UBC-Rocket/Thrust-Vectoring-II/README.md

# Thrust-Vectoring-II

Trying our best to make our rockets go up straight and not turn into a missile...
