UBC-Rocket/Thrust-Vectoring-II/Mechanical/Gimbal v29.step

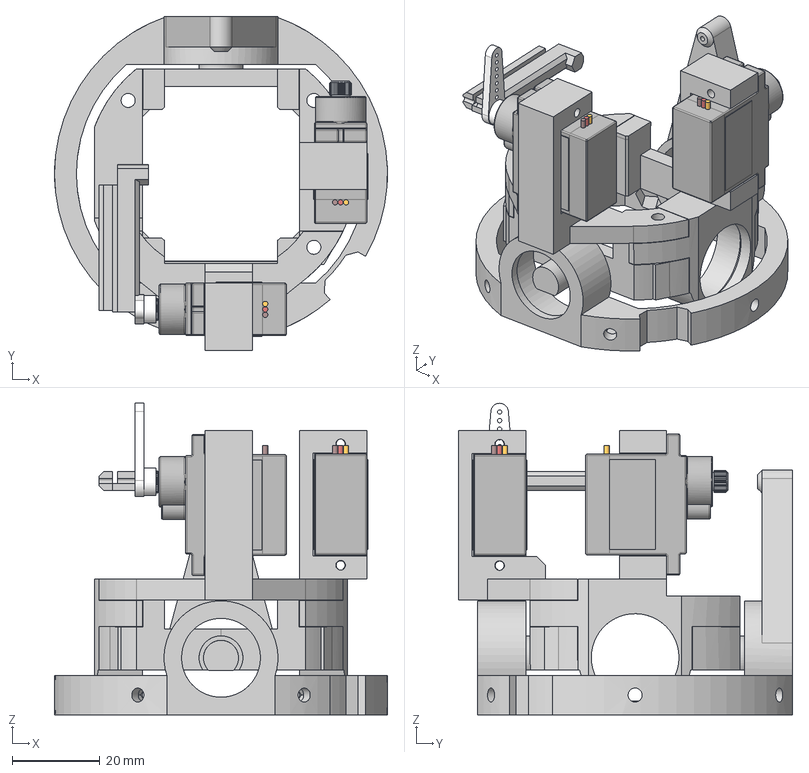
[picture p1: CAD file, 2024-10-06]
Mechanical/Gimbal v29.step
76.0 x 76.3 x 71.1 mm
Servo-MG90S
Servo-MG90S_1
outer ring
MG90S horn
jig
