UBC-Rocket/Thrust-Vectoring-II/Simulation/test.odt

Note to self: NEED TO ADD CLAMPING

Rocket Gimbal Testing Plan

Setup:

- Rocket body assembled, with the USB-A cord dangling out so code can be flashed on to it
- Rocket body clamped in a position off the ground so that it is hanging
- Motor placed in gimbal, electrically taped to keep it in place for testing

Test 0: Gimbal Only/Focused (if rocket bnot setup yet)

Methodology:

- Have terminal open while testing (of course) and display PID value, servo PWM, and Kalmann angle side by side
- Hold the rocket, change angles, and observe how sensitive to changes the gimbal is (e.g. how fast or how angled does the rocket need to be in order for the gimbal to react)

Objective: Smooth gimbal movement, reactive to changes

Test I: Gimbal Movement

Methodology:

- Use different Kp, Ki, Kd values, informed by Simulink model and Bode plot analysis
- Holding the rocket, change the angles to observe gimbal movement
- Check for abrupt jumps (in all tests)

Objective: Obtain smooth gimbal movement, sensitive to changes

Observations:

X | Y | Kd | Behaviour
1,1 | 0,0 | 0,0 | Too jittery and not aggressive enough to small change
0.6,1.345 | 0.3,1.3997 | 0.0538, 0.1887 | More aggressive, but laggy and slow
Kp: 0.4663 Ki: 0.4492 Kd: 0.0291 | Kp: 0.2655 Ki: 3.6239 Kd: 0.0049 | | Not really jittery, not aggressive enough at all
5,1,1 | 5,1,1 | | Smooth like butter but honestly the rocket is biased towards one side
0.0456414702196055,0.00221472983928474, 0.208987093269671 | | | Very jittery, stuck; I reversed the polarities and it goes in the right direction now Im pretty sure, so -outputX, +outputY, but it’s just so slow
0.955695119137231, 0.0686777734979202, 0.165773491656206 | | | Jitter and now aggressive enough
0.287978208479341, 0.035101, 0.52495 | | | Jitter, stable, but not enough correct force ? Lots of abrupt umps in y axis PWM gets stuck on 20 in both cases at quilibrium

Test II: Impulse Response

Methodology:

- Tip the rocket in one direction instantaneously
- Time restabilization period and number of oscillations
- Ensure to test for +/- x, +/-y, and +/-xy directions
- Check for overshoot
- Increase angel and force of tipping

Objective: Minimize stabilization time and overshoot

Observations:

Kp | Ki | Kd | Behaviour

Test III: Step Response

Methodology:

- Tip the rocket in one direction and keep it in that direction
- Observe gimbal
- Ensure to test for +/- x, +/-y, and +/-xy directions
- Check for overshoot
- Increase angle of push and push force

Objective: Minimize stabilization time and overshoot

Observations:

Kp | Ki | Kd | Behaviour
