UBC-Rocket/Thrust-Vectoring-II/(threads)

Thread 12 (2024-12-31):

Rocket State Machine

Shengw3n, 2024-12-31:
The state machine should have five states:
- Idle: awaiting launch, no pid inputs
- Ignition: motor ignition
-  Ascent: pid input begin, TVC actively controls rocket orientation, flight data begin recording
- Descent: TVC deactivate and parachute deployed
- Landing: flight data recording saved and ready for file transport

Closed 2025-08-07.

Thread 8 (2024-12-31):

Angle State Estimation

Shengw3n, 2024-12-31:
- Stable angle estimation without using the accelerometer (data is inaccurate while the rocket is moving)
- Filter implementation is needed

Shengw3n, 2025-03-23:
Kalman filter for angle estimation, when engine starts, disable accelerometer’s influence

Thread 21 (2025-01-19):

IMU Calibration

Shengw3n, 2025-01-19:
Every IMU will need a individual calibration.

My way of calibrating include manual calibration for accelerometer (with a leveler) and an auto calibration for gyroscope (when the rocket is not moving gyro value should be zero). See previous project for example: https://github.com/UBC-Rocket/Thrust-Vectoring/blob/main/Active_Stabilization.ino

Closed 2025-08-07.

Thread 22 (2025-01-19):

Gimbal Callibration

Shengw3n, 2025-01-19:
this is to be done with a leveler after gen 2 gimbal connection is finished

also account for dx change in gimbal movement, good point brought up by jeffery

JeffreyYJackson, 2025-01-20:
Hey steven, can you move this to in progress?

JeffreyYJackson, 2025-01-26:
I tried to write a function for the servo angle using the motor angle(Angle servo(angleMotor)) but the trig relationships are very complex and I don't think its possible to have a simplified relationship. I suggest characterizing the relationship by approximating using a polynomial.

Closed 2025-08-07.

Thread 24 (2025-01-19):

Watchdog Timer

Shengw3n, 2025-01-19:
Add a watchdog timer to avoid code lock up

Shengw3n, 2025-01-26:
@JeffreyYJackson Can you test the watchdog timer by intentionally breaking the I2C protocol and see if it detects? (maybe remove the IMU while running, and see if watchdog detects)

Thread 28 (2025-01-26):

Improve Esp32 Server Request Handling

DennisY888, 2025-01-26:
for Wifi_Control.cpp:
- replaces character-by-character request parsing with proper HTTP handling
- add "flight" endpoint for A command, not just raw data
- modify remote_control.py to send to this new endpoint instead of raw bytes for A

Closed 2025-03-09.

Thread 35 (2025-03-30):

STOP ESP32 server connection detection once command sent

DennisY888, 2025-03-30:
the periodical attempt of connection detection from the ESP32 server causes noticeable delay/blocking of the IMU data in terminal print

Closed 2025-08-07.
