UBC-Rocket/Thrust-Vectoring-II/Avionics/Hardware/REV2_PCB/TVR_Avionics.pdf

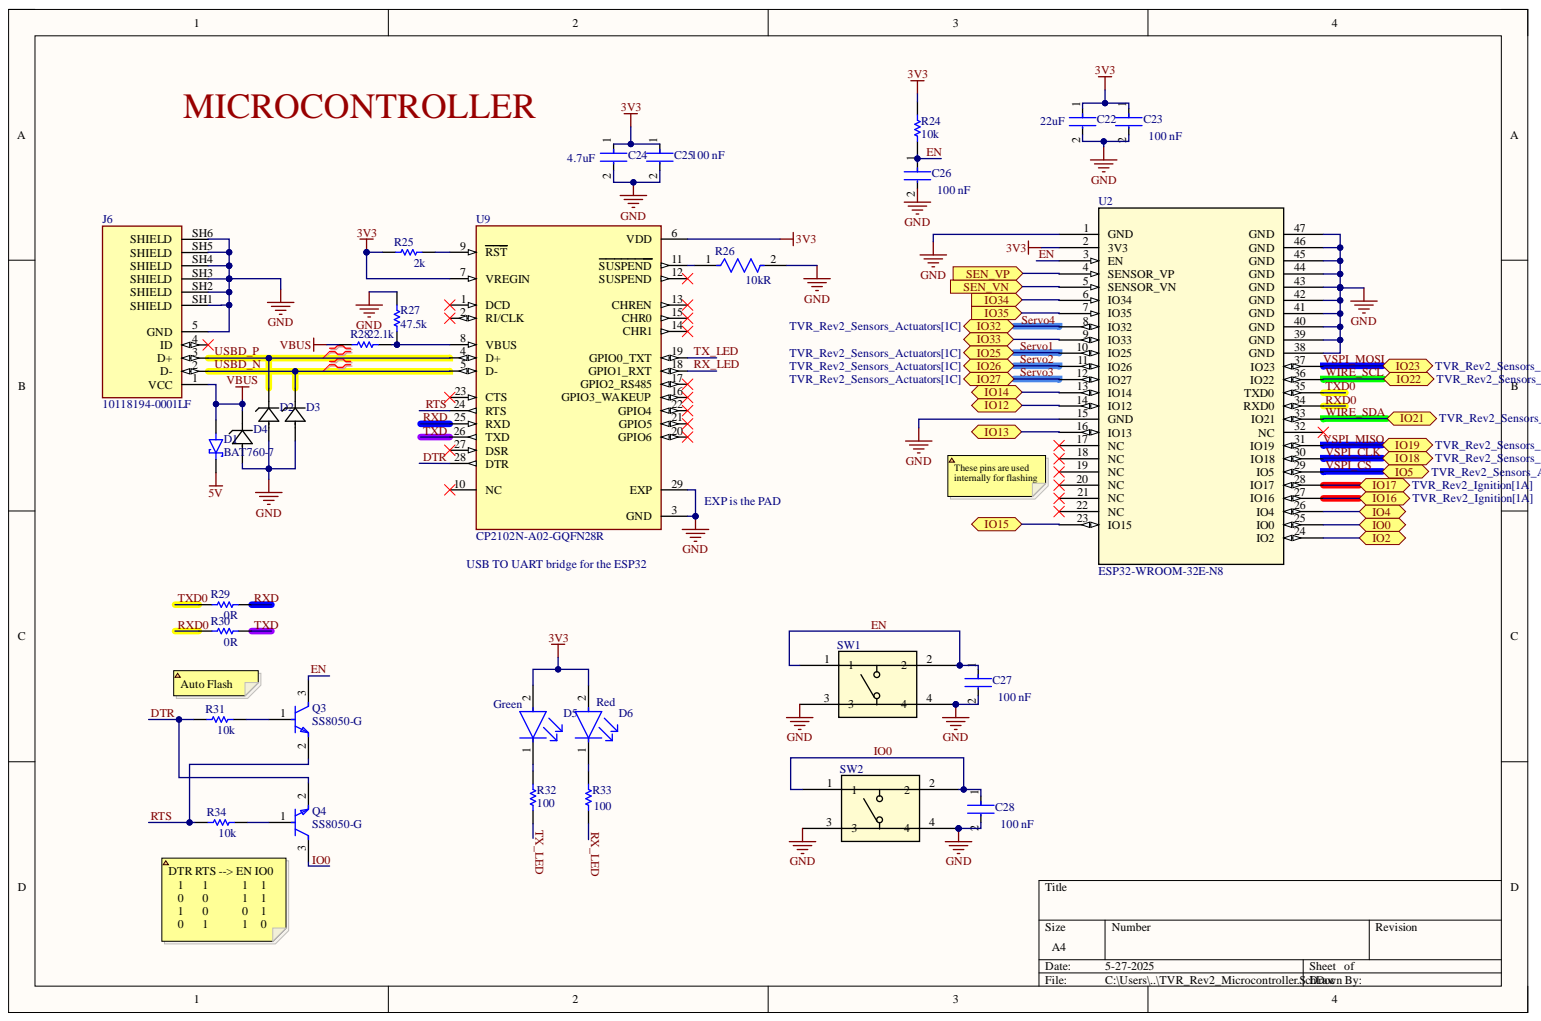
[picture p2: page 1]

2 USBD _N | 5

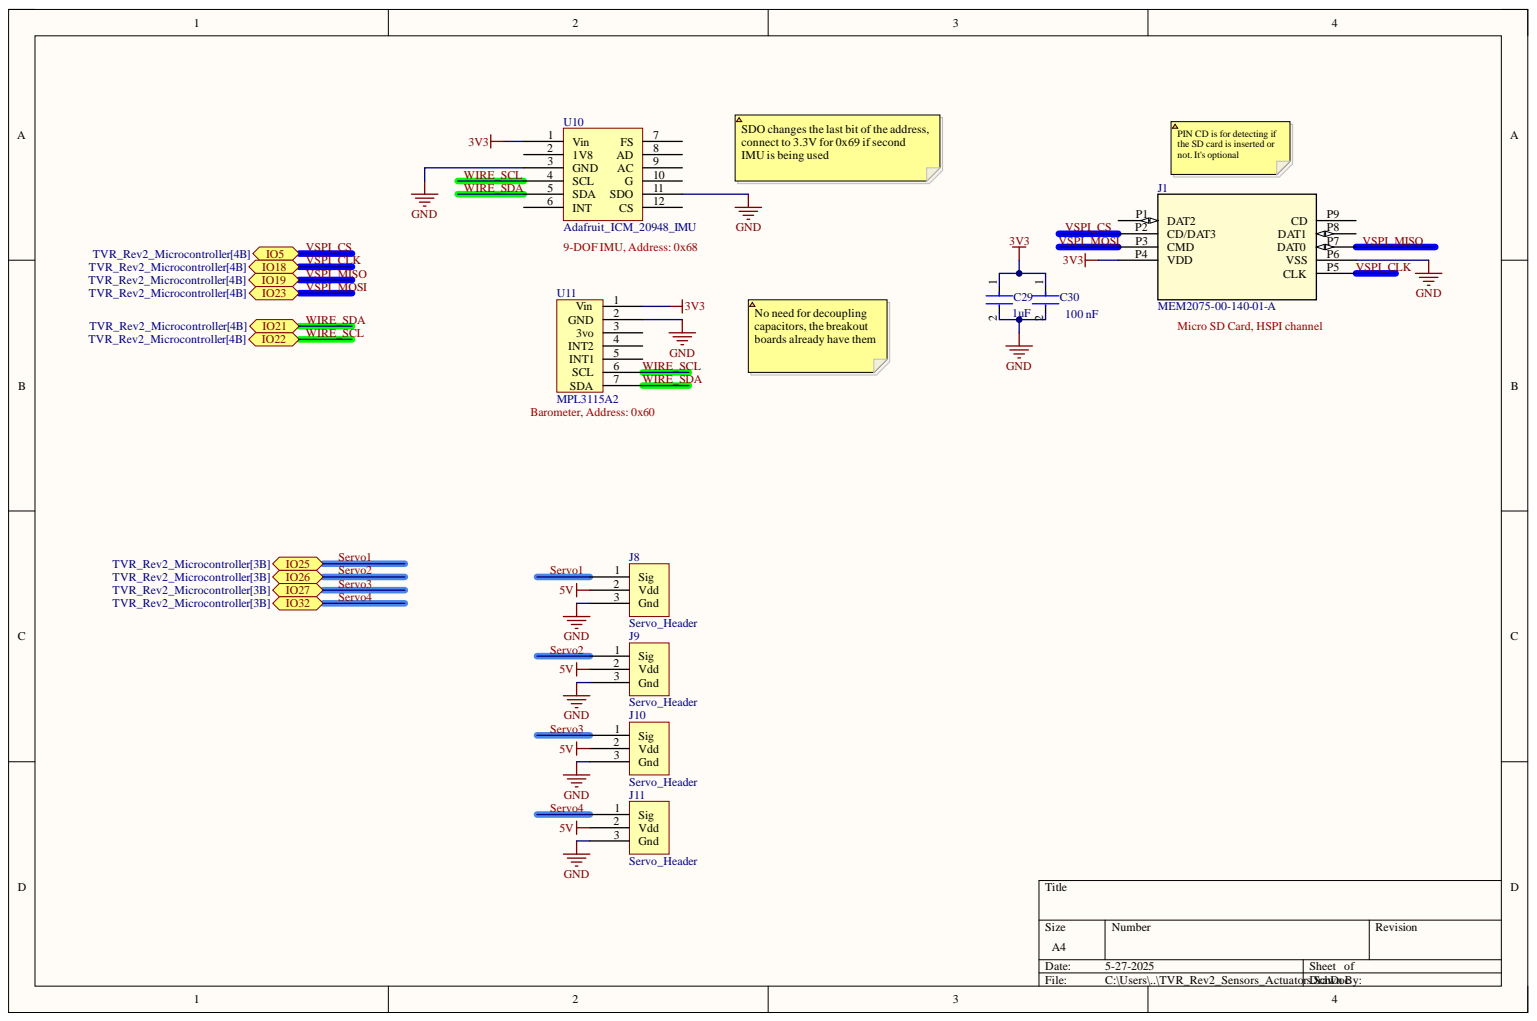
[picture p3: page 2]

SDO changes the last bit of the address,
connect to 3.3V for 0x69 if second
IMU is being used

PIN CD is for detecting if
the SD card is inserted or
not. It's optional

No need for decoupling
capacitors, the breakout
boards already have them

MEM2075-00-140-01-A
Micro SD Card, HSPI channel

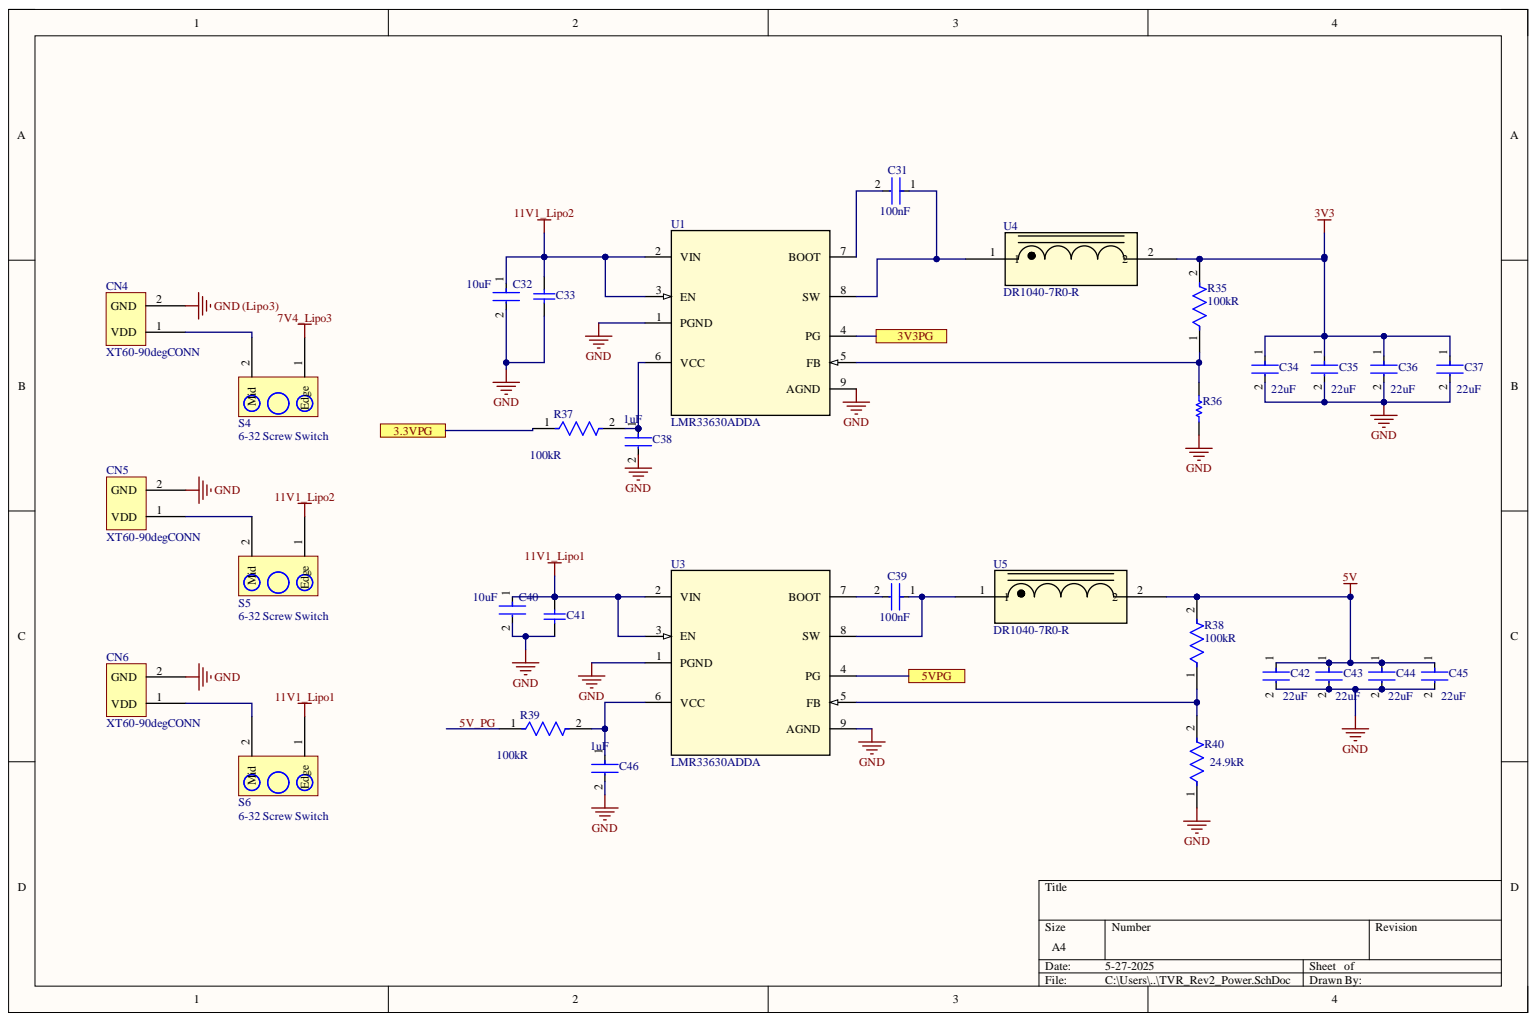
[picture p4: page 3]

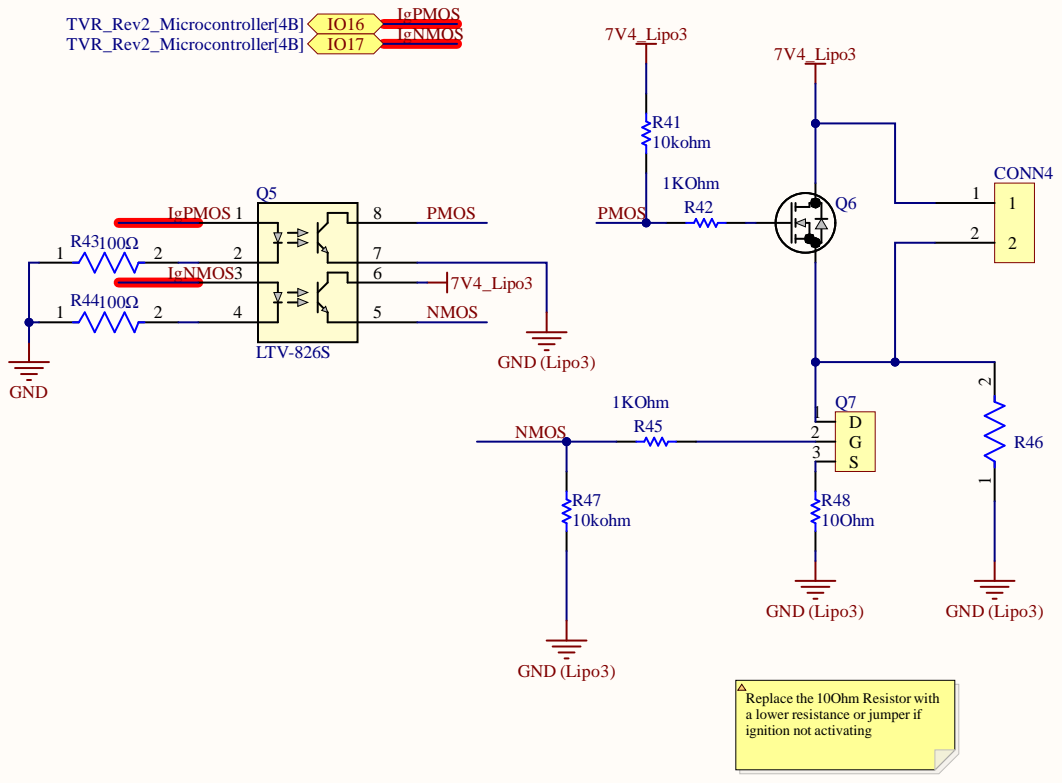
[picture p5: page 4]

Replace the 10Ohm Resistor with
a lower resistance or jumper if
ignition not activating

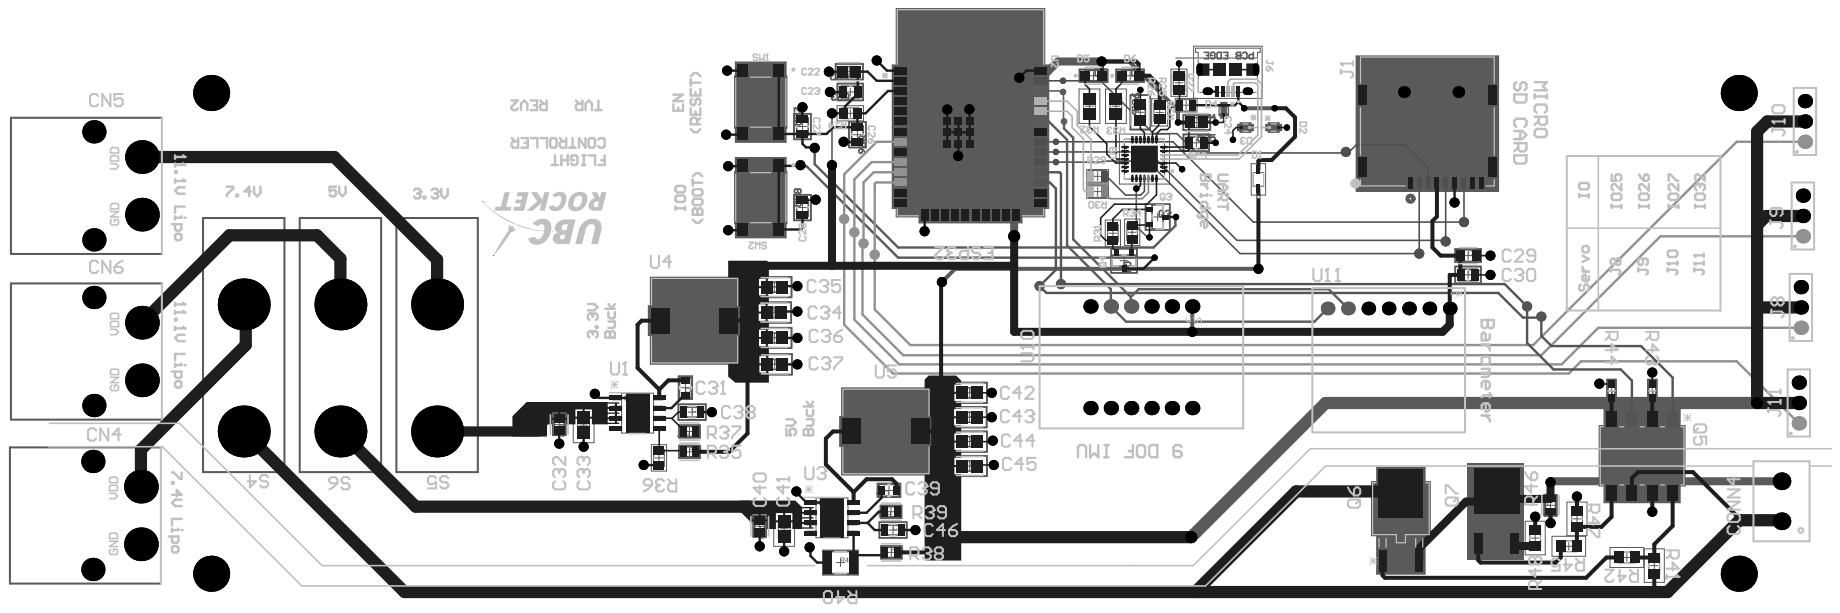
[picture p6: page 5]
