UBC-Rocket/Thrust-Vectoring-II/(list of files, drawings)

Other design files:
Avionics/Hardware/PCB/PCB1.PcbDoc
Avionics/Hardware/PCB/PcbLib1.PcbLib
Avionics/Hardware/PCB/Schlib2.SchLib
Avionics/Hardware/PCB/TVR_Rev1.SchDoc
Avionics/Hardware/REV2_PCB/TVR.PcbLib
Avionics/Hardware/REV2_PCB/TVR.SchLib
Avionics/Hardware/REV2_PCB/TVR_Rev2.SchDoc
Avionics/Hardware/REV2_PCB/TVR_Rev2_Ignition.SchDoc
Avionics/Hardware/REV2_PCB/TVR_Rev2_Microcontroller.SchDoc
Avionics/Hardware/REV2_PCB/TVR_Rev2_Power.SchDoc
Avionics/Hardware/REV2_PCB/TVR_Rev2_Sensors_Actuators.SchDoc
