UBC-Rocket/Thrust-Vectoring-II/(commit log)

2024-10-06 Add files via upload
    Arduino library for interpolation of thrust data
2024-10-20 Added IMU Support
2024-11-03 PID Function Added, Comments Improved
2024-12-01 Create Thrust input
2024-12-01 Update Thrust input
2024-12-01 Create servo_delay(seconds, fps, reaction_t)
2025-01-12 Update IMU README documentation
2025-01-12 IMU Control
    Set up files for IMU Configurations
2025-01-12 PID Control System Seperated
2025-01-19 GYRO/ACCEL Calibration and File System Formatting
    Moved GYRO/ACCEL Calibration to IMU_Control and added checks to see if file system initializes correctly. If not, it gets formatted.
    [IMU_Control.cpp, IMU_Control.h, PID_Control.cpp, Wifi_Control.h, flightdata.cpp, flightdata.h, main.cpp]
2025-01-26 Watchdog Timer implementation
2025-01-26 Revert "Commit"
    This reverts commit f6490f1b499eab04cf32b0b7f8464c1d2295e4a4.
    [main.cpp]
2025-01-26 Revert "Merge pull request #27 from UBC-Rocket/Watchdog-Timer"
    This reverts commit 1b6f1bddbd30dd25151fdf7212d62867dc16d7bb, reversing
    changes made to 0a24caebdb41dea81ba816eadf41e965f2f51886.
    [IMU_Control.cpp, IMU_Control.h, flightdata.cpp, main.cpp]
2025-02-09 Fixed issue 19. Axes are now swapped (it must be known whether the IMU was rotated about its x-axis or y-axis). For PID, use the values in the currentData object as the true x, y, z values.
    [flightdata.cpp]
2025-02-23 added remote control for esp32
2025-03-09 ESP32 Server C++/Python GUI
2025-03-30 Initial commit with simulation code
    [CGvsTime.csv, RollvsYaw.csv, newrocket.csv]
2025-05-11 ignition circuit auto shutdown and switched from toggle to explicit state management, every time command A sent, ignition circuit turns on, then automatically turns off after 2 seconds
2025-05-11 very funny files
    [rocket_data.csv]
2025-05-18 State Machine Prototype
2025-05-18 State Machine Prototype Refactored
2025-05-26 Kalman filter and main integration
2025-05-27 rev2 for review
    [TVR.PcbLib, TVR.SchLib, TVR_Rev2.SchDoc, TVR_Rev2_Ignition.SchDoc, TVR_Rev2_Microcontroller.SchDoc, TVR_Rev2_Power.SchDoc, TVR_Rev2_Sensors_Actuators.SchDoc]
2025-06-01 Add PID inputs/outputs to CSV data; Remove magnometer and temperature from code
2025-06-01 Fix CSV header order
    [flightdata.cpp]
2025-06-01 Simple Thrust Based Model
2025-06-09 folder cleanup; flight data and latest simulation upload
    [CGvsTime.csv, RollvsYaw.csv, flight_data-08-06-2025.csv, flight_data_processed-25-05-2025.csv, newrocket.csv, open-rocket-sim.csv, rocket_data.csv]
2025-07-06 improved code flow
2025-07-06 thrust curve
    [rocket_sim_data.csv]
2025-07-06 updated state machine to use timer-based approach
2025-07-17 small angle approximation data
    [servo gimbal mapping - Sheet1.csv, servo gimbal mapping.xlsx]
2025-08-02 hold down test
    [flight_data_28_07_2025.csv]
2025-08-03 feat: kalman filter more aggressive tuning
2025-08-03 fix: server pausing loop
    [main.cpp]
2025-08-04 feat: PID update
2025-08-09 Simulation updates, bode plots implemented
    [closed_loop_metrics.csv, closed_loop_metricsX.csv, closed_loop_metricsY.csv, closed_loop_simulation.csv, closed_loop_simulationX.csv, closed_loop_simulationY.csv]
2025-08-09 feat: update PID and gimbal mapping
2025-08-10 fix: adjust motor burn duration
    [StateMachine.cpp]
2025-08-10 feat: new pid values
